carlostex98/ORGA_P4_snake_B_G2/placas/buffer_salida.PDF

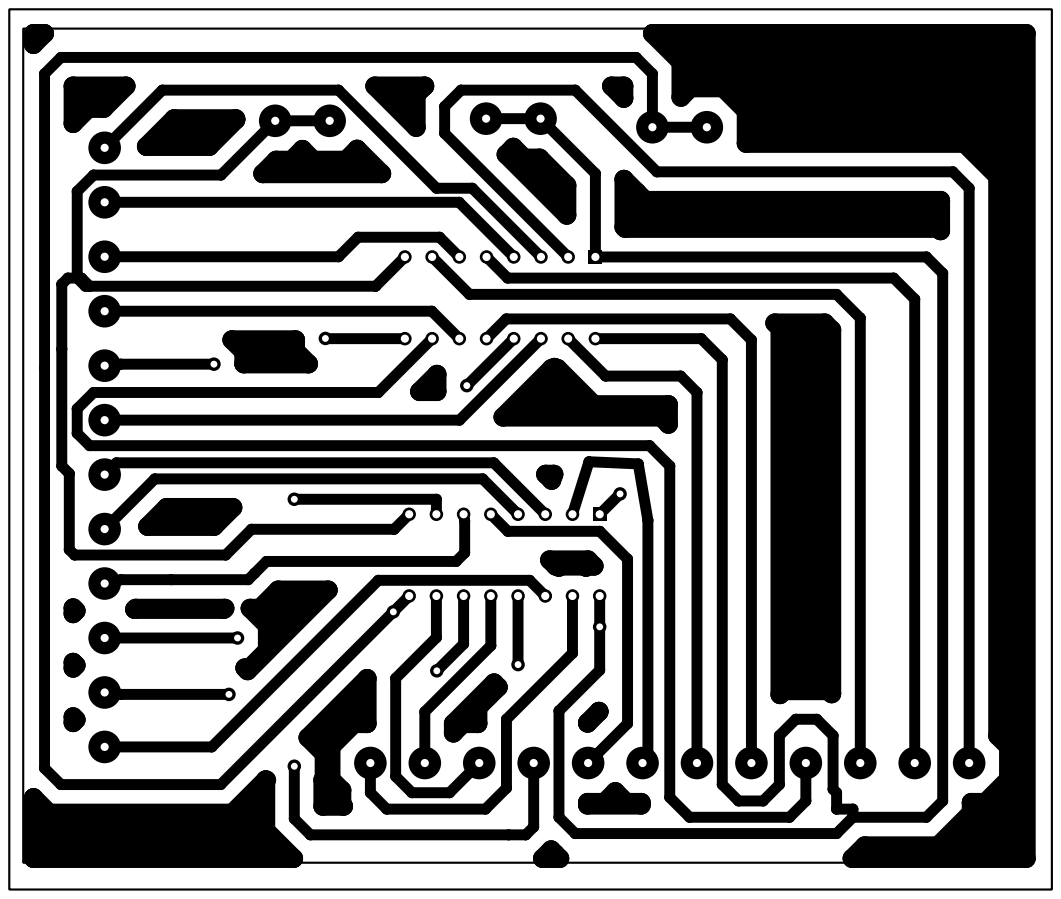
[picture p7: page 1]
