carlostex98/ORGA_P4_snake_B_G2/placas/cont_maestro.PDF

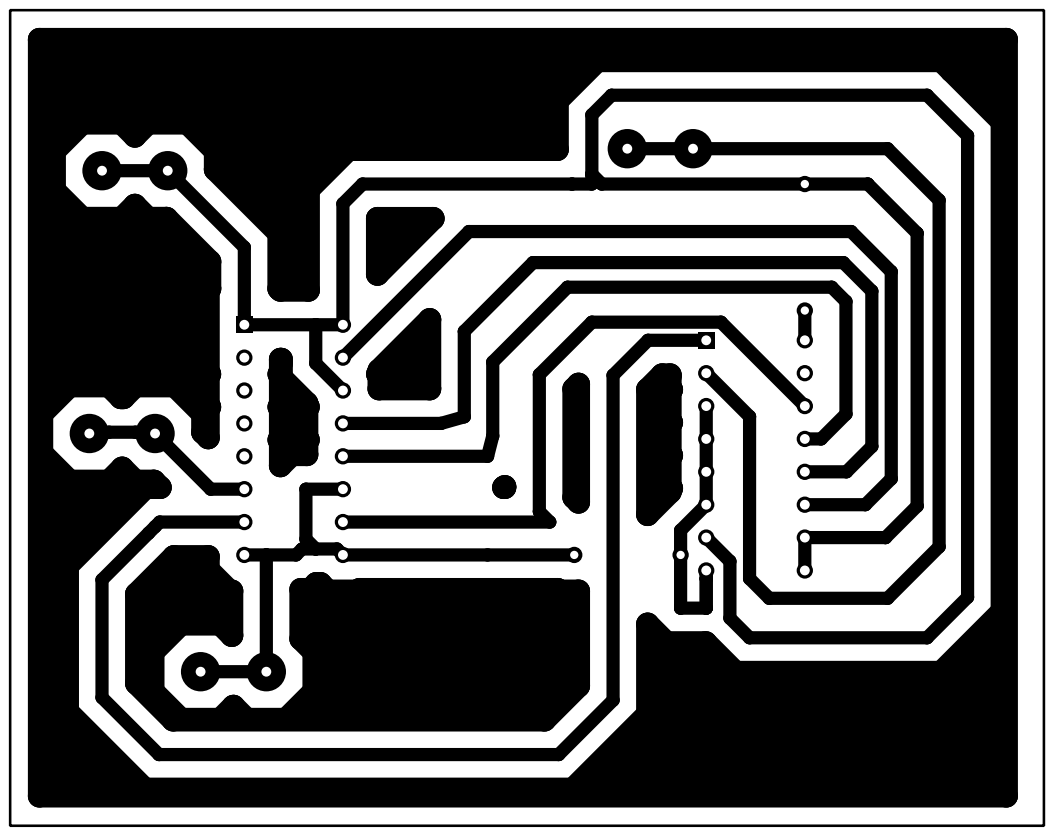
[picture p8: page 1]
