carlostex98/ORGA_P4_snake_B_G2/placas/memoria_serial.PDF

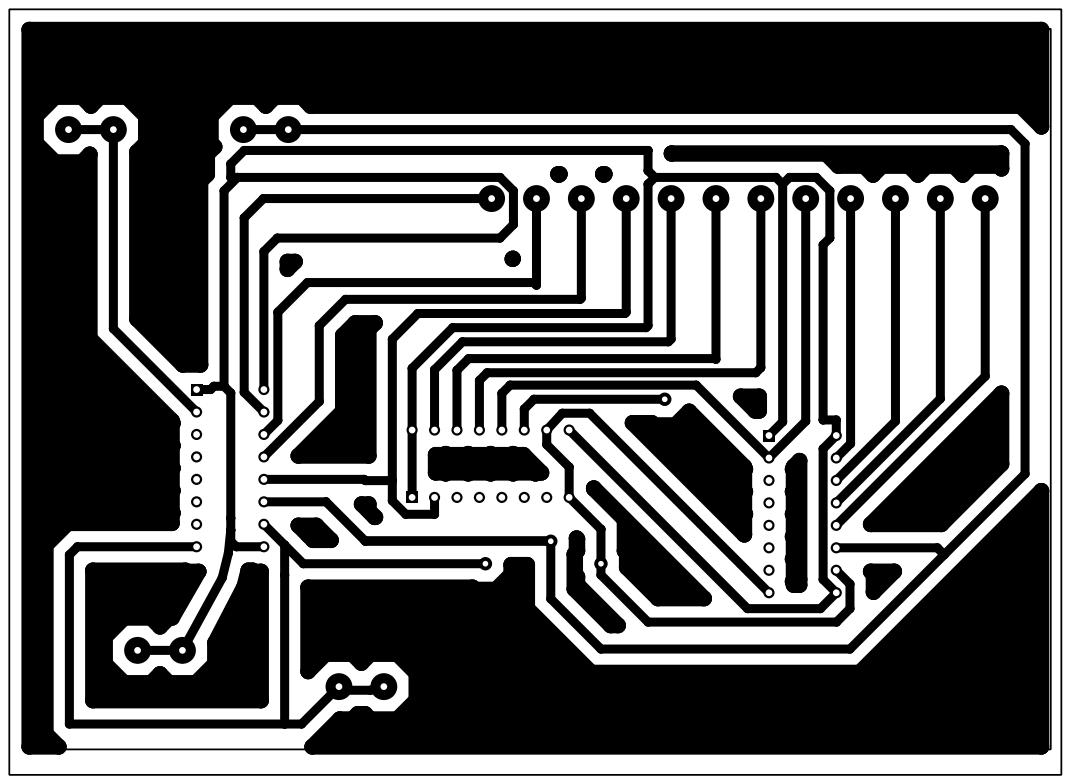
[picture p9: page 1]
