carlostex98/ORGA_P4_snake_B_G2/placas/multiplex.PDF

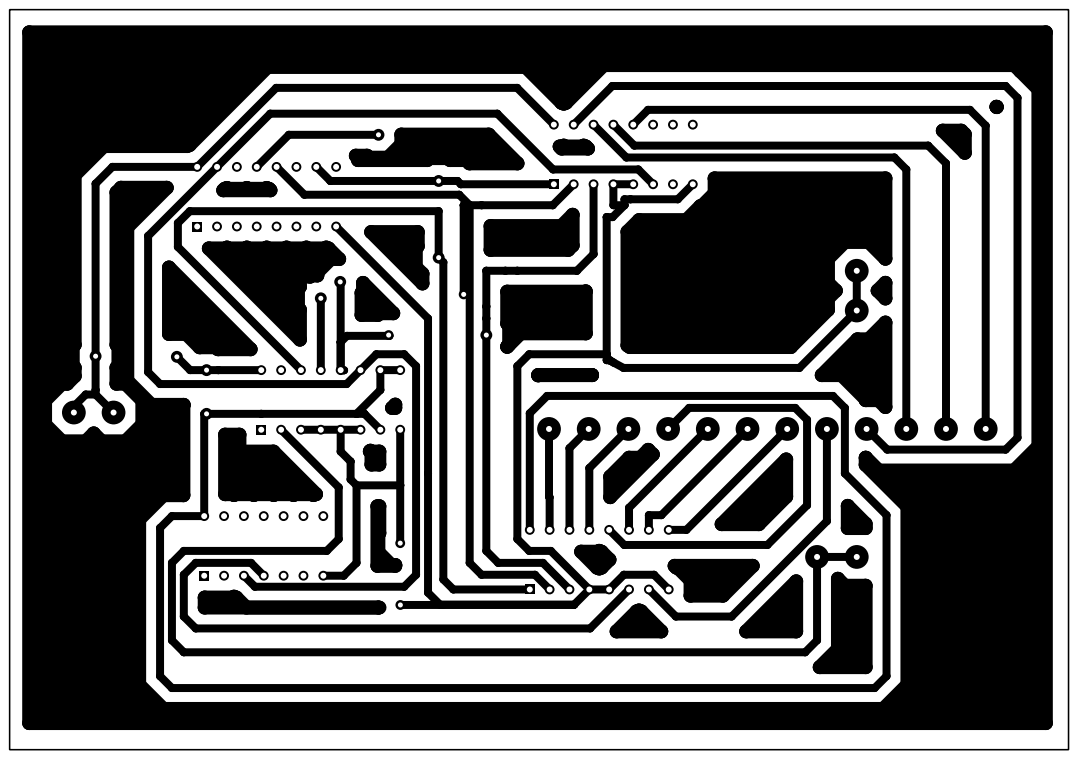
[picture p10: page 1]
