carlostex98/ORGA_P4_snake_B_G2/(list of files, drawings)

Other design files:
Simulaciones/ram_juego.pdsprj
Simulaciones/teclado_juego.pdsprj
Simulaciones/todo_en_uno.pdsprj
